liku232/brushless_driver/README.md

# 3 Phasen Inverter
Verpflichtendes TGM-Sommerprojekt
- [Lastenheft](Lastenheft.md)
- [Linkliste](linklist.md)
