liku232/brushless_driver/linklist.md

# Liste wichtiger links

## Inhalt
- [Quellen](#quellen)
- [Datenblätter](#datenblätter)
- [Bauteile](#bauteile)

## Quellen
- [Bachelorarbeit Markus Mueller](https://elib.dlr.de/125274/1/Bachelorarbeit%20Markus%20Mueller%20Oktober%202018.pdf) - Bachelor Arbeit einer Motorsteuerung
- [PI-Regler Siemens](https://cache.industry.siemens.com/dl/files/479/23753479/att_6290/v4/23753479_set23_regsim_v23_de.pdf)
- [Highside Driver Erklärung](https://www.google.com/url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)
- [RTOS-Doku](http://forum.chibios.org/viewforum.php?f=16&sid=02a26b939d4fd279c1aa4d55d5838f95)

## Datenblätter
 - [MOSFET-Treiber](https://docs.rs-online.com/5d53/0900766b80acd35c.pdf)

## Beuteilvertreiber
- [Vishay](https://www.vishay.com/)

## Bauteile
- [Bauteilliste](Labor.xlsx)
- [Nucleo-64 STM32 - RS-Components](https://at.rs-online.com/web/p/entwicklungstools-microcontroller/9064624)
