liku232/brushless_driver/Fortschrittsbericht_Sommerprojekt_v1.docx

Erreichte Ziele in Sätzen formulieren

- Die Schaltfrequenz, Zwischenkreisspannung und Ausgangsstrom wurden bestimmt
- Simulation von der Strombegrenzung gemacht
- 3 Halbbrückenschaltng simuliert
- Erster Prototypenaufbau der 3 Halbrückenschaltung und die Messung der induktiven last wurden durchgeführt
- Neues stm32 gefunden
- Gelernt wie man auf CHIBIOS Studio programmiert
