liku232/brushless_driver/Tagesprotokoll_Sommerprojekt_v1.docx

03.03.2022

Die Schaltung der Strombegrenzung wurde simuliert

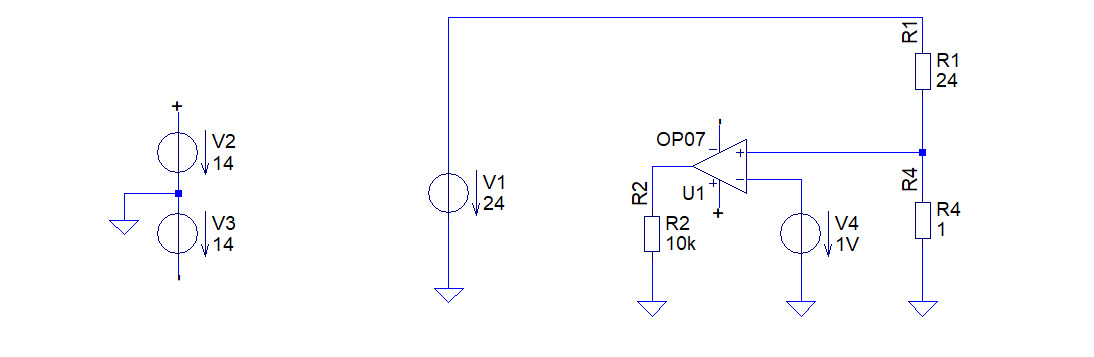
[picture p1: figure]

Simulieren der einer Halbbrueckenschaltung mit induktiver Last auf LTspice

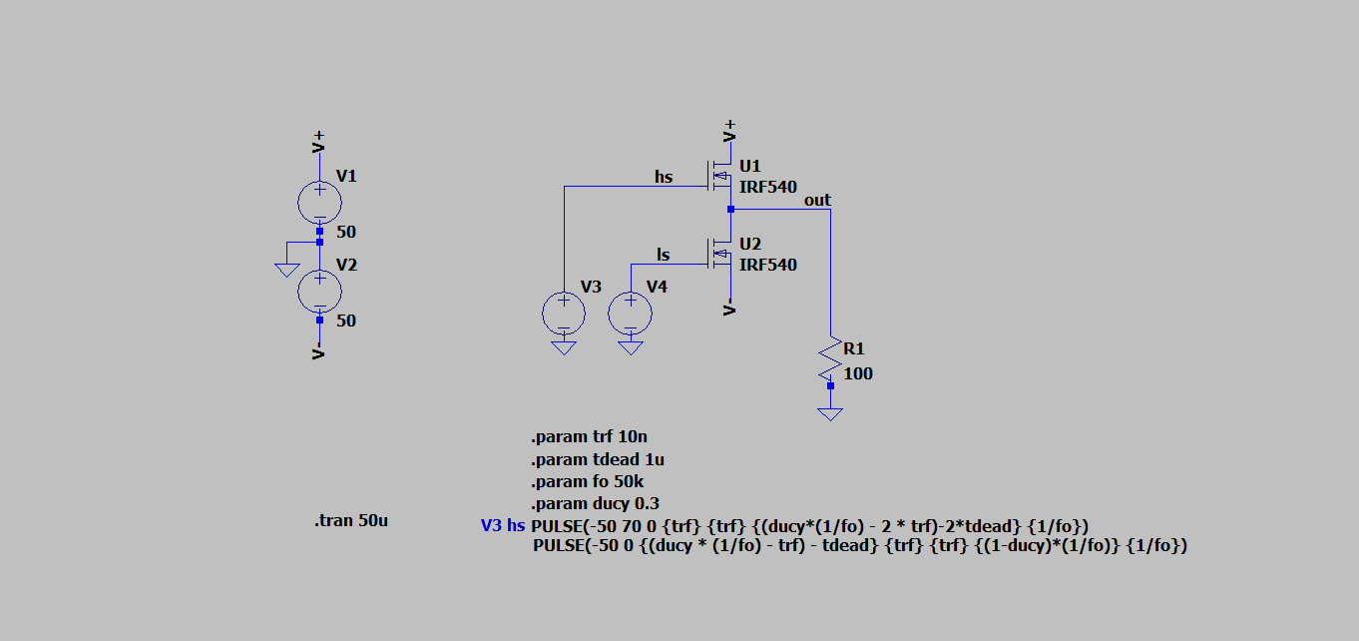
[picture p2: figure]
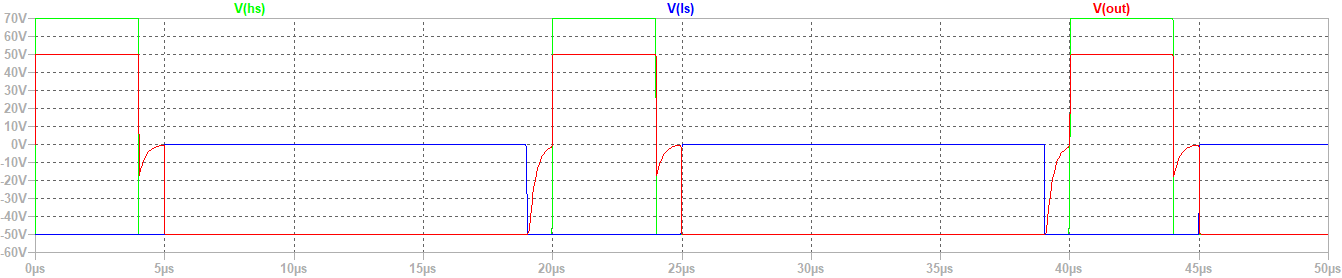
[picture p3: figure]

10.03.2022
