liku232/brushless_driver/Bauteilliste_v2.xlsx

Bauteil | Beschreibung | Menge | Rs Best Nr
IRF540 | N-Channel MOSFET | 6 | in der Schule
30CTQ045 | Schottky diode | 6 | in der Schule
L6387E | MOSFET Treiber | 6 | 445-630
LKSR 25-NP | Stromsensor | 3 | 200-3818
STM32 Nucleo64 STM32F446RET6 | MCU | 1 | 906-4624
