liku232/brushless_driver/PCB/mainboard/motor_driver_mainboard_v2.step

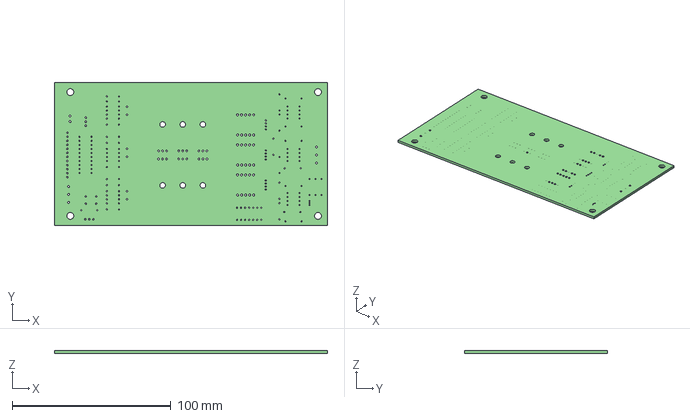
[picture p4: CAD file, 2022-06-23]
PCB/mainboard/motor_driver_mainboard_v2.step
172.0 x 90.0 x 1.60 mm
