liku232/brushless_driver/PCB/mainboard/motor_driver_mainboard_v2.kicad_pcb

## KiCad design PCB/mainboard/motor_driver_mainboard_v2.kicad_pcb (2022-06-23)

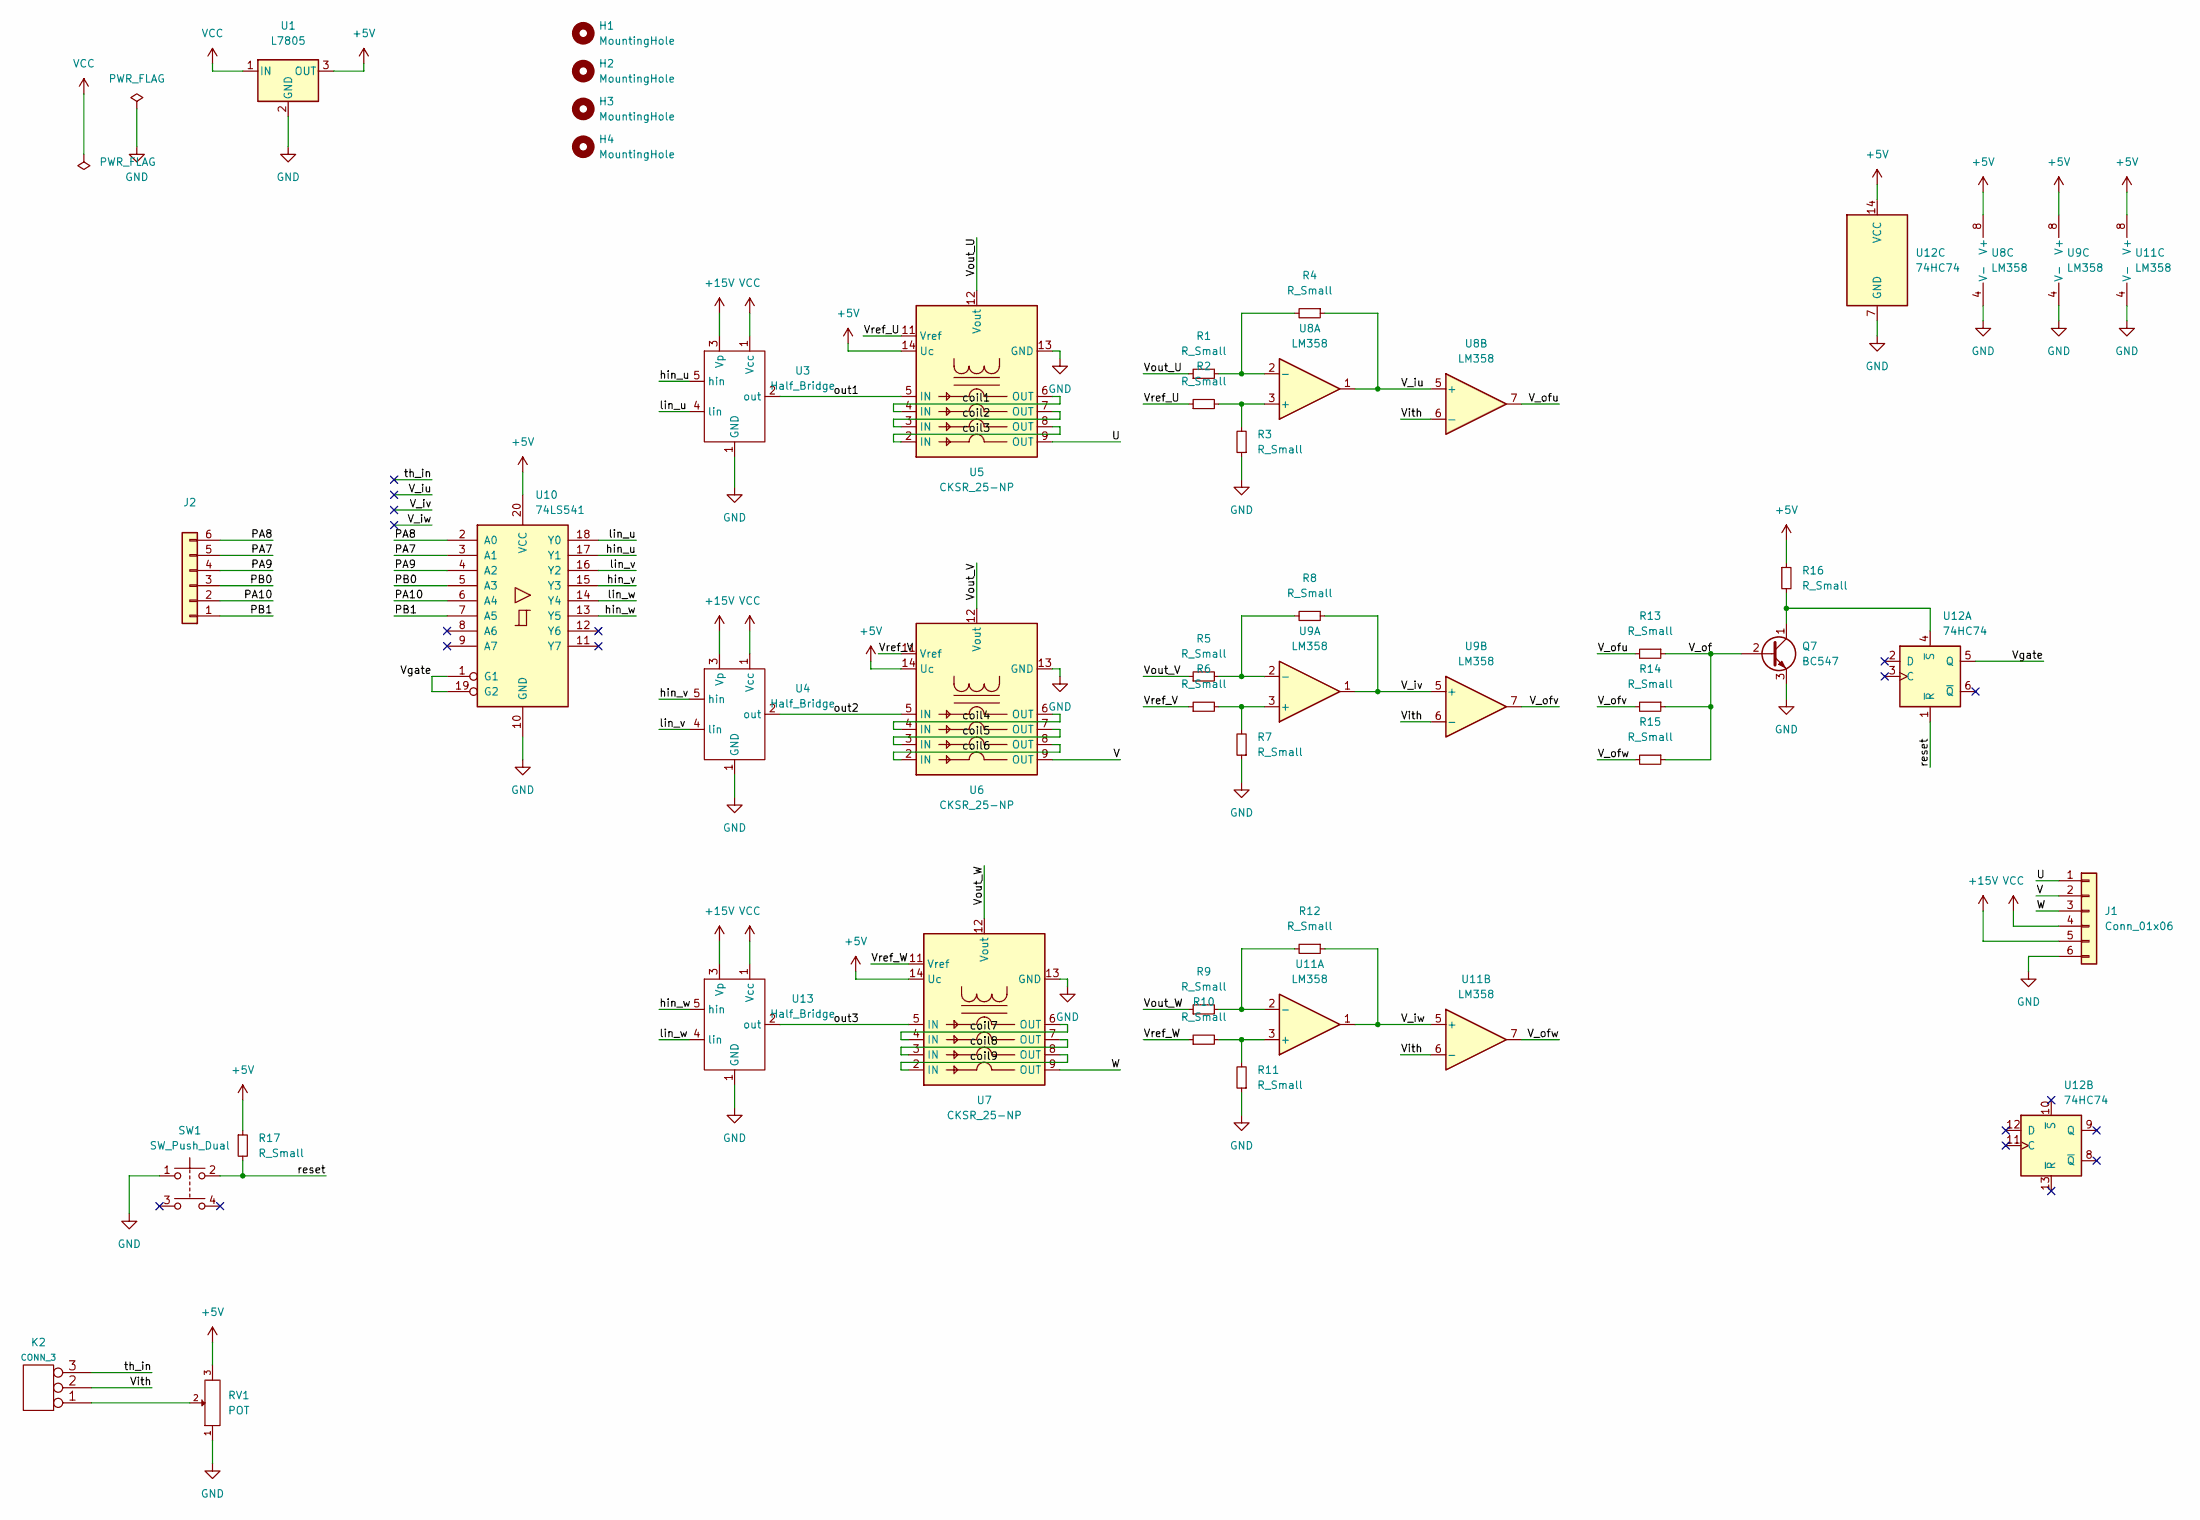
[picture p5: schematic motor_driver_mainboard_v2.kicad_sch]

Parts:
H1, H2, H3, H4: MountingHole; MountingHole_4.3mm_M4
J1: Conn_01x06; PhoenixContact_MSTBVA_2,5_6-G-5,08_1x06_P5.08mm_Vertical
J2: (no value)
K2: CONN_3; PinHeader_1x03_P2.54mm_Vertical
Q7: BC547; TO-92_Inline
R1, R2, R3, R4, R5, R6, R7, R8, R9, R10, R11, R12, R13, R14, R15, R16, R17: R_Small; R_1206_3216Metric_Pad1.30x1.75mm_HandSolder
RV1: POT; Potentiometer_Piher_T-16H_Single_Horizontal
SW1: SW_Push_Dual; SW_TH_Tactile_Omron_B3F-10xx
U1: L7805; TO-220-3_Vertical
U3, U4, U13: Half_Bridge; half_bridge
U5, U6, U7: CKSR_25-NP; LEM_CKSR
U8, U9, U11: LM358; DIP-8_W7.62mm_Socket_LongPads
U10: 74LS541; DIP-20_W7.62mm_Socket_LongPads
U12: 74HC74; DIP-14_W7.62mm_Socket_LongPads

Connections:
+5V: R16.1, R17.1, RV1.3, U1.3 (OUT), U5.14 (Uc), U6.14 (Uc), U7.14 (Uc), U8.8 (V+), U9.8 (V+), U10.20 (VCC), U11.8 (V+), U12.14 (VCC)
+15V: J1.5, U3.3 (Vp), U4.3 (Vp), U13.3 (Vp)
/PA7: J2.5, U10.3 (A1)
/PA8: J2.6, U10.2 (A0)
/PA9: J2.4, U10.4 (A2)
/PA10: J2.2, U10.6 (A4)
/PB0: J2.3, U10.5 (A3)
/PB1: J2.1, U10.7 (A5)
/U: J1.1, U5.9 (OUT)
/V: J1.2, U6.9 (OUT)
/V_iu: R4.1, U8.1, U8.5 (+)
/V_iv: R8.1, U9.1, U9.5 (+)
/V_iw: R12.1, U11.1, U11.5 (+)
/V_of: Q7.2 (B), R13.1, R14.1, R15.1
/V_ofu: R13.2, U8.7
/V_ofv: R14.2, U9.7
/V_ofw: R15.2, U11.7
/Vgate: U10.1 (G1), U10.19 (G2), U12.5 (Q)
/Vith: K2.2 (PM), U8.6 (-), U9.6 (-), U11.6 (-)
/Vout_U: R1.1, U5.12 (Vout)
/Vout_V: R5.1, U6.12 (Vout)
/Vout_W: R9.1, U7.12 (Vout)
/Vref_U: R2.1, U5.11 (Vref)
/Vref_V: R6.1, U6.11 (Vref)
/Vref_W: R10.1, U7.11 (Vref)
/W: J1.3, U7.9 (OUT)
/coil1: U5.4 (IN), U5.6 (OUT)
/coil2: U5.3 (IN), U5.7 (OUT)
/coil3: U5.2 (IN), U5.8 (OUT)
/coil4: U6.4 (IN), U6.6 (OUT)
/coil5: U6.3 (IN), U6.7 (OUT)
/coil6: U6.2 (IN), U6.8 (OUT)
/coil7: U7.4 (IN), U7.6 (OUT)
/coil8: U7.3 (IN), U7.7 (OUT)
/coil9: U7.2 (IN), U7.8 (OUT)
/hin_u: U3.5 (hin), U10.17 (Y1)
/hin_v: U4.5 (hin), U10.15 (Y3)
/hin_w: U10.13 (Y5), U13.5 (hin)
/lin_u: U3.4 (lin), U10.18 (Y0)
/lin_v: U4.4 (lin), U10.16 (Y2)
/lin_w: U10.14 (Y4), U13.4 (lin)
/out1: U3.2 (out), U5.5 (IN)
/out2: U4.2 (out), U6.5 (IN)
/out3: U7.5 (IN), U13.2 (out)
/reset: R17.2, SW1.2, U12.1 (~R)
/th_in: K2.3
unnamed: K2.1, RV1.2
unnamed: Q7.1 (C), R16.2, U12.4 (~S)
unnamed: R1.2, R4.2, U8.2 (-)
unnamed: R2.2, R3.2, U8.3 (+)
unnamed: R5.2, R8.2, U9.2 (-)
unnamed: R6.2, R7.2, U9.3 (+)
unnamed: R10.2, R11.2, U11.3 (+)
unnamed: R9.2, R12.2, U11.2 (-)

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
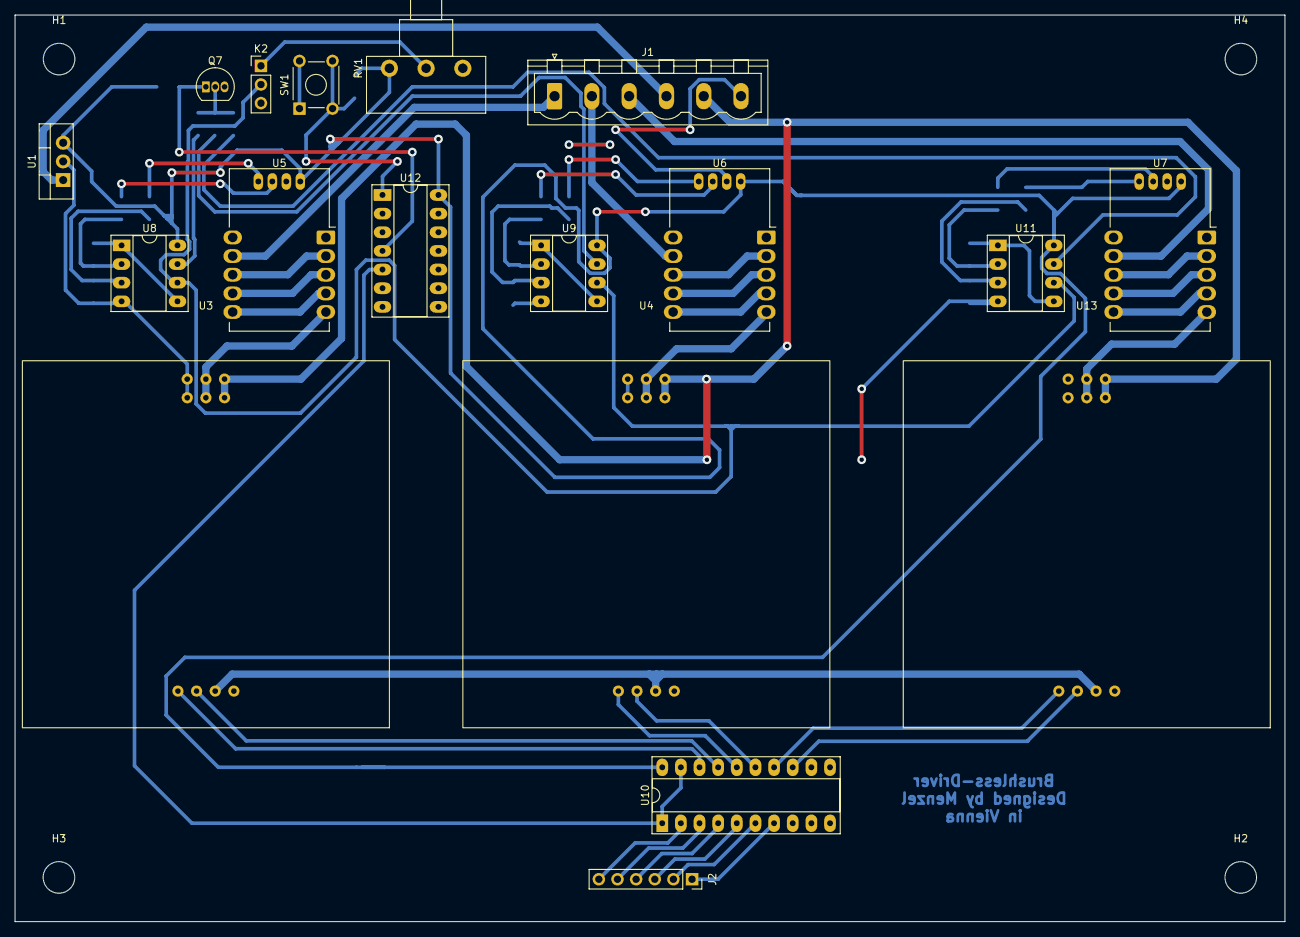
[picture p6: board motor_driver_mainboard_v2.kicad_pcb from above]

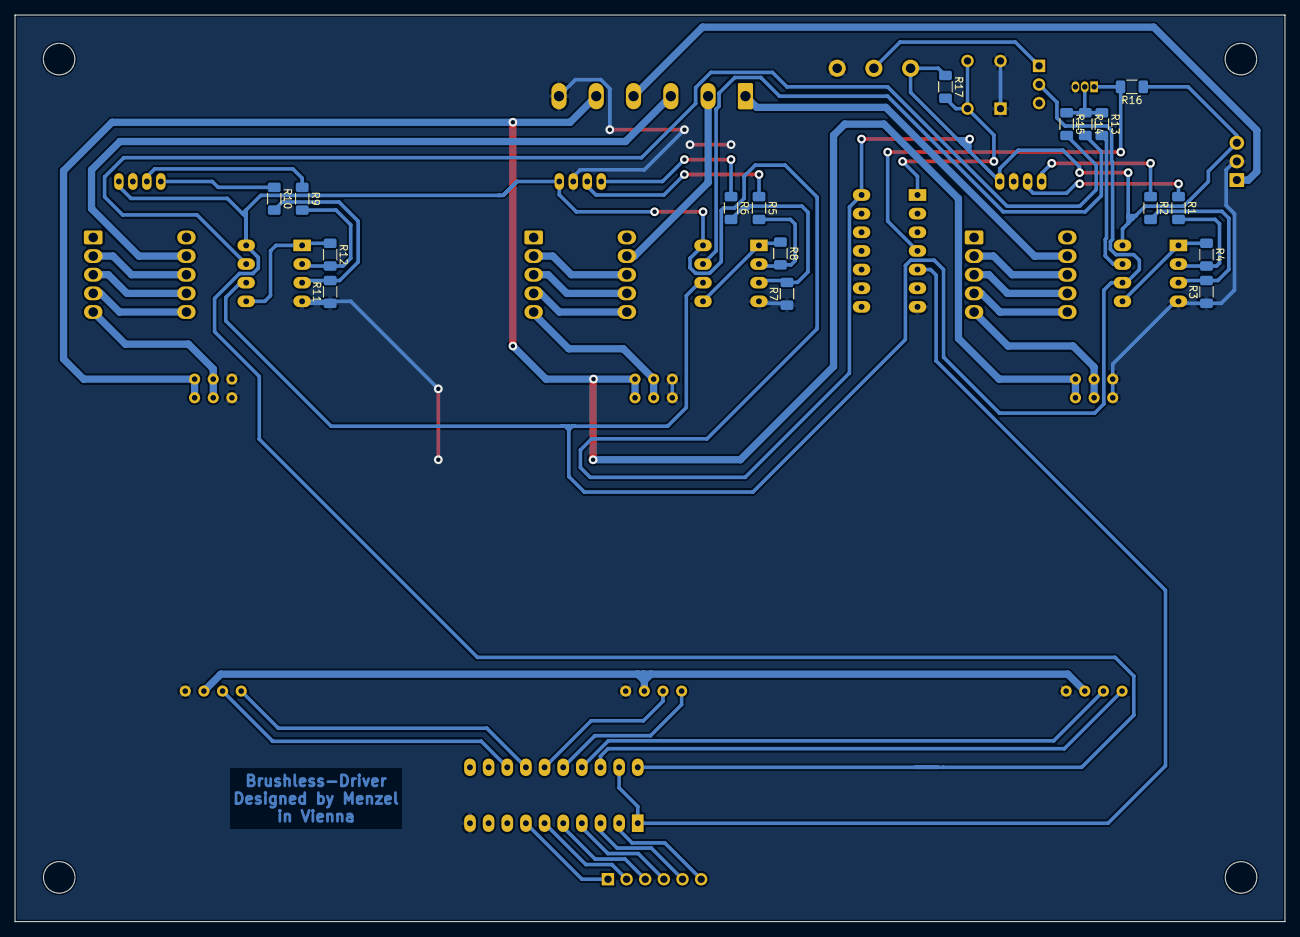
[picture p7: board motor_driver_mainboard_v2.kicad_pcb from below]

Board: 2 copper layers, 173.0 x 123.5 mm, 39 parts (17 on the bottom side), 55 nets.
