liku232/brushless_driver/PCB/module/motor_driver_v3.kicad_pcb

## KiCad design PCB/module/motor_driver_v3.kicad_pcb (2022-06-23)

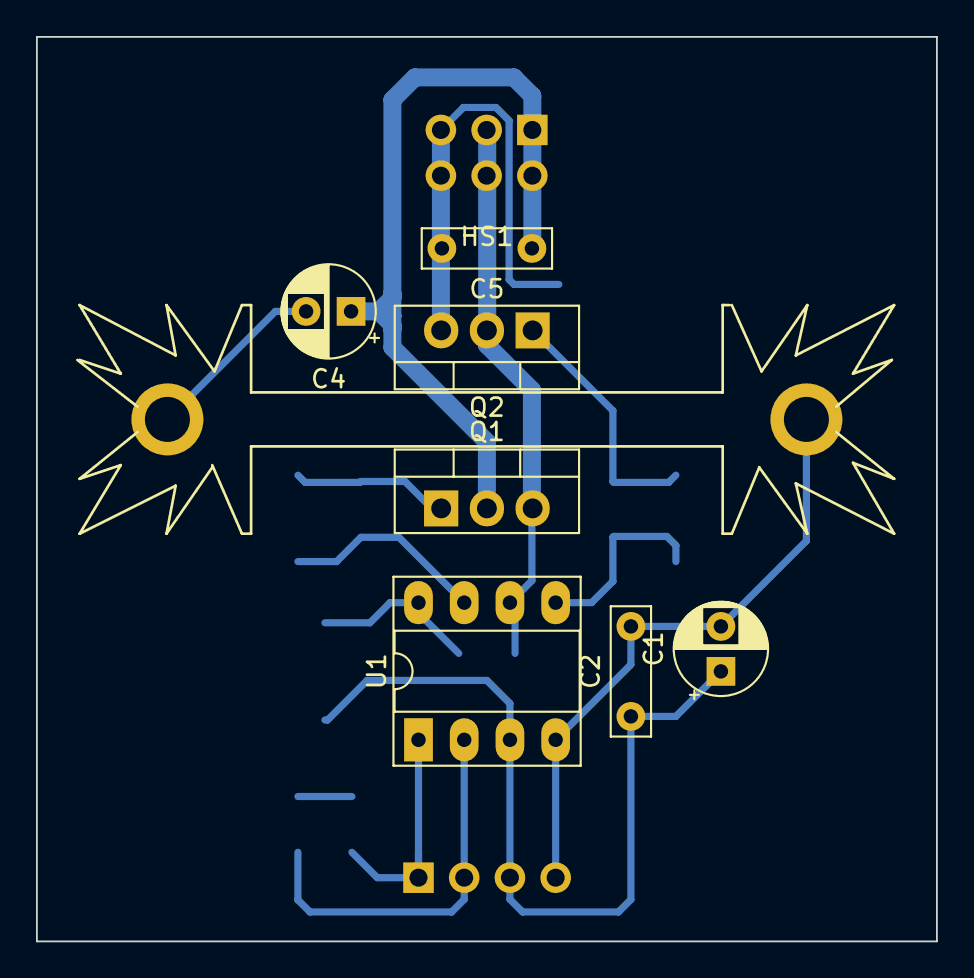
[picture p8: board motor_driver_v3.kicad_pcb from above]

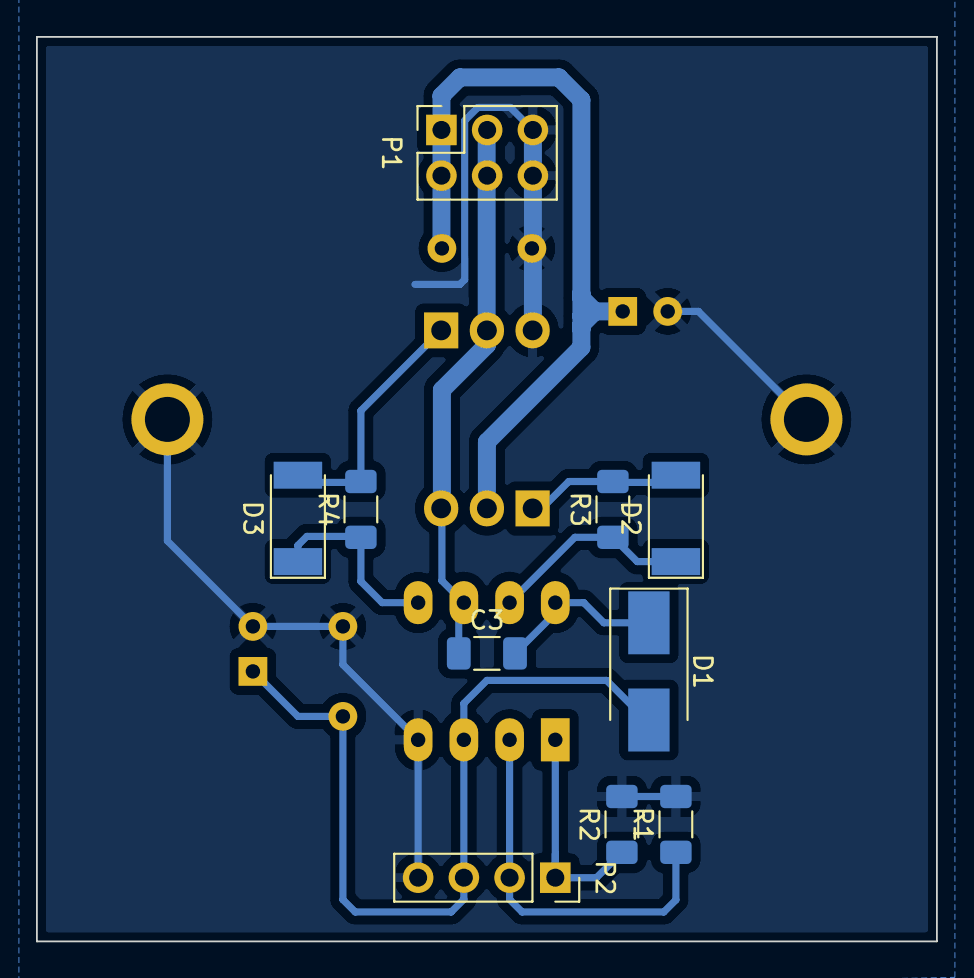
[picture p9: board motor_driver_v3.kicad_pcb from below]

Board: 2 copper layers, 50.0 x 50.2 mm, 18 parts (10 on the bottom side), 11 nets.

Parts:
C1, C4: CP1; CP_Radial_D5.0mm_P2.50mm
C2, C5: C; C_Rect_L7.0mm_W2.0mm_P5.00mm
C3: C; C_1206_3216Metric_Pad1.33x1.80mm_HandSolder
D1: D_Schottky; D_SMB_Handsoldering
D2, D3: D_Schottky; D_MELF
HS1: Heatsink_Pad; Heatsink_Fischer_SK409_2xDrill2.3mm_soldered
P1: CONN_3X2; PinSocket_2x03_P2.54mm_Vertical
P2: CONN_4; PinSocket_1x04_P2.54mm_Vertical
Q1, Q2: IRF540N; TO-220-3_Vertical
R1, R2, R3, R4: R; R_1206_3216Metric_Pad1.30x1.75mm_HandSolder
U1: L6387E; DIP-8_W7.62mm_Socket_LongPads

Connections:
+24V: C4.1, C5.1, P1.1, P1.2, Q1.2 (D)
/Vghs1: D2.1 (K), R3.1, U1.7 (HVG)
/Vgls1: D3.1 (K), R4.1, U1.5 (LVG)
/hin1: P2.2, R1.1, U1.2 (HIN)
/lin1: P2.1, R2.1, U1.1 (LIN)
/out: C3.1, P1.3, P1.4, Q1.3 (S), Q2.2 (D), U1.6 (OUT)
GND: C1.2, C2.2, C4.2, C5.2, HS1.1, P1.5, P1.6, P2.4, Q2.3 (S), R1.2, R2.2, U1.4 (GND)
unnamed: C3.2, D1.1 (K), U1.8 (Vboot)
unnamed: D2.2 (A), Q1.1 (G), R3.2
unnamed: D3.2 (A), Q2.1 (G), R4.2
VCC: C1.1, C2.1, D1.2 (A), P2.3, U1.3 (Vcc)
